AdrianScancich/Mechatronics-Final-Project-Winter26-/docs/images/Bumper.png

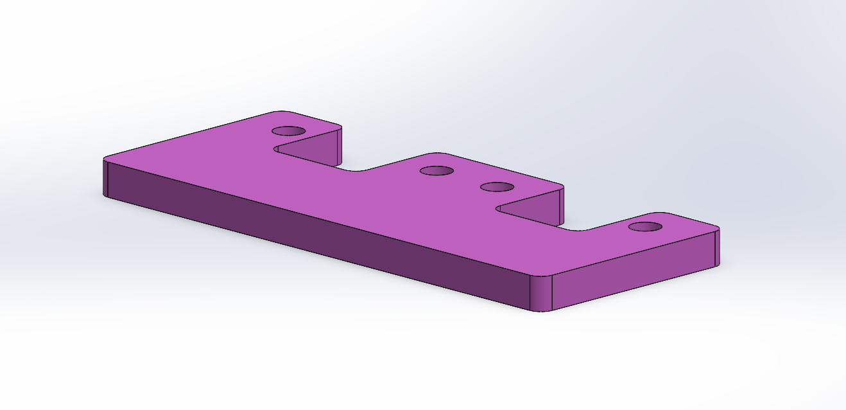
docs/images/Bumper.png
