AdrianScancich/Mechatronics-Final-Project-Winter26-/docs/images/RomiTopDown.jpg

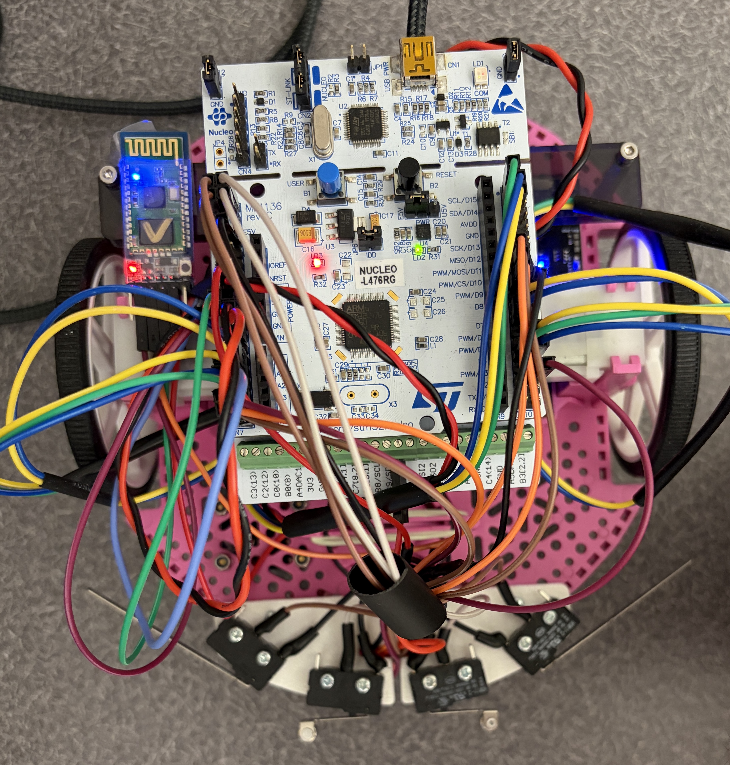
docs/images/RomiTopDown.jpg
