AdrianScancich/Mechatronics-Final-Project-Winter26-/CAD/Bumper.SLDPRT

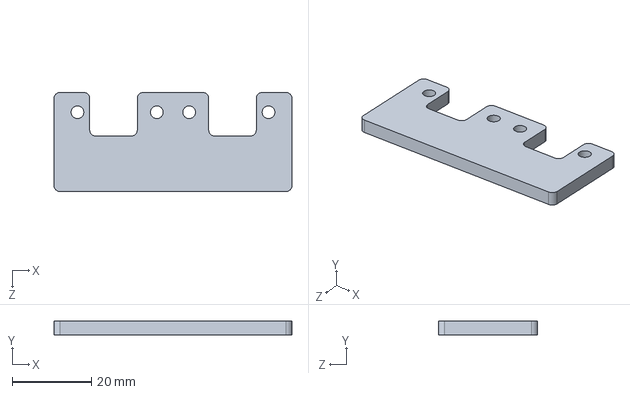
[picture p16: CAD file, 2026-03-20]
CAD/Bumper.SLDPRT
60.0 x 3.50 x 25.0 mm
