AdrianScancich/Mechatronics-Final-Project-Winter26-/CAD/Snap-Action Switch.SLDPRT

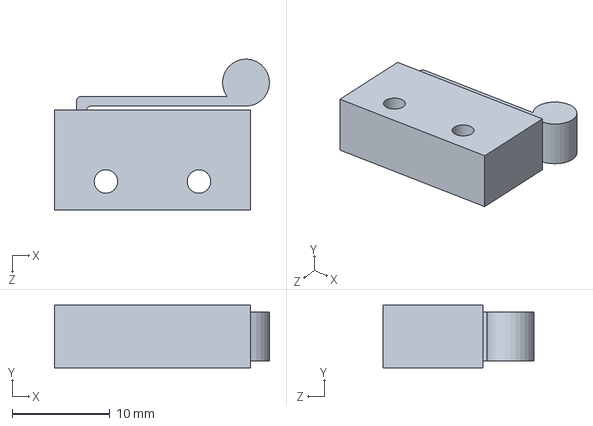
[picture p17: CAD file, 2026-03-20]
CAD/Snap-Action Switch.SLDPRT
21.9 x 6.40 x 15.4 mm
