AdrianScancich/Mechatronics-Final-Project-Winter26-/CAD/IMU Mount.SLDPRT

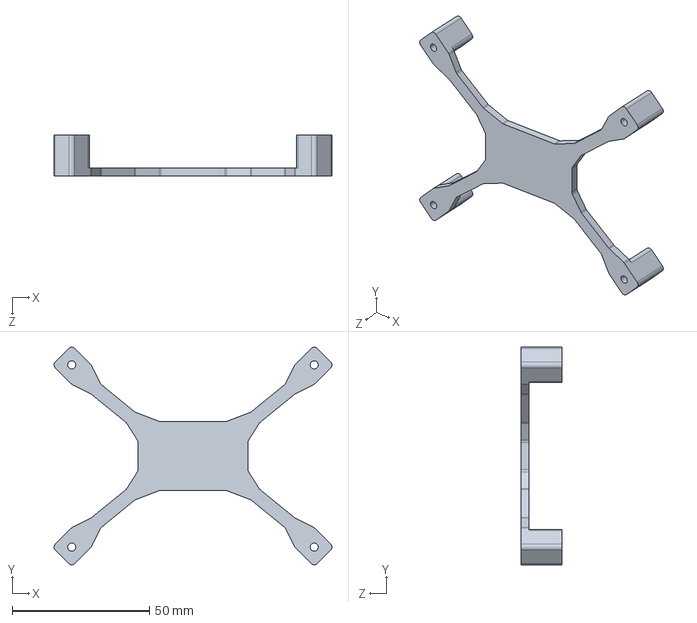
[picture p18: CAD file, 2026-03-20]
CAD/IMU Mount.SLDPRT
101.1 x 79.2 x 15.0 mm
