AdrianScancich/Mechatronics-Final-Project-Winter26-/CAD/qtr-hd-06x.SLDPRT

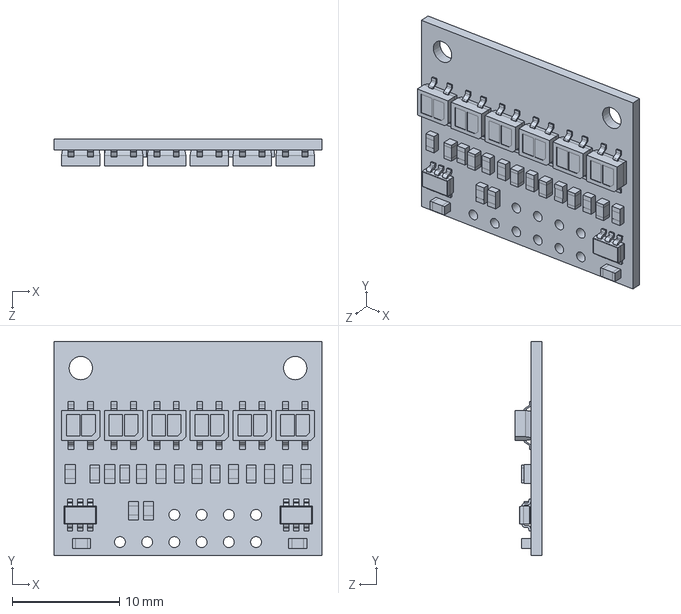
[picture p19: CAD file, 2026-03-20]
CAD/qtr-hd-06x.SLDPRT
25.0 x 20.0 x 2.52 mm
