AdrianScancich/Mechatronics-Final-Project-Winter26-/CAD/QTR Mount.SLDPRT

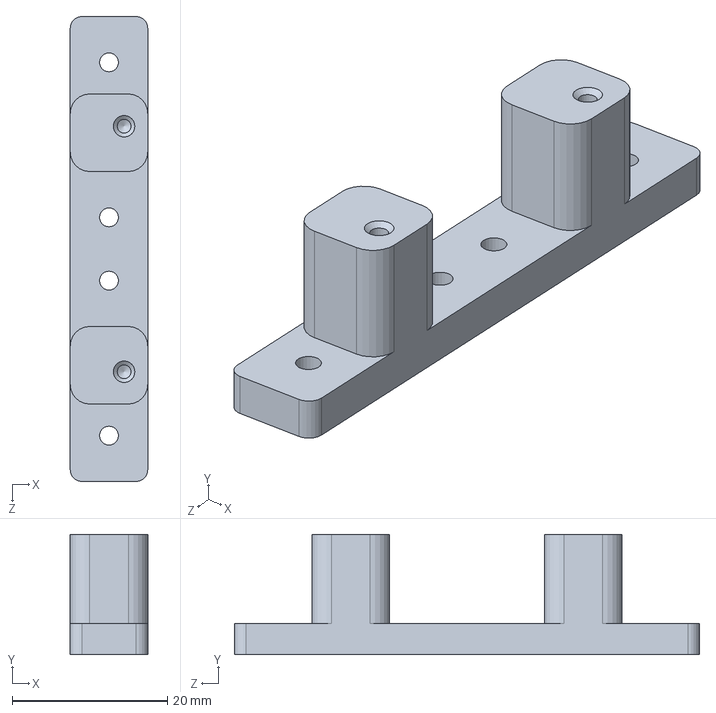
[picture p20: CAD file, 2026-03-20]
CAD/QTR Mount.SLDPRT
10.0 x 15.5 x 60.0 mm
