AdrianScancich/Mechatronics-Final-Project-Winter26-/CAD/Bump Sensor Mount.SLDPRT

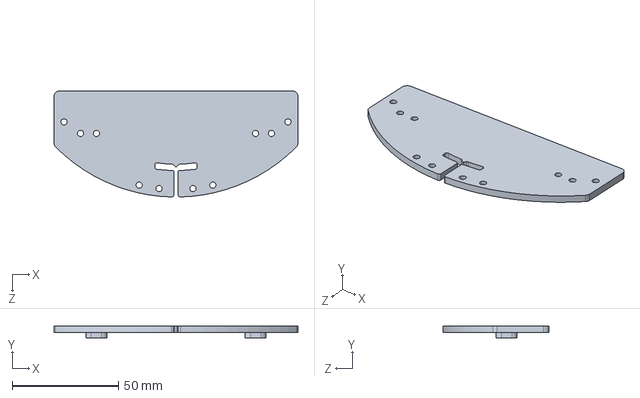
[picture p21: CAD file, 2026-03-20]
CAD/Bump Sensor Mount.SLDPRT
115.0 x 5.50 x 50.0 mm
