AdrianScancich/Mechatronics-Final-Project-Winter26-/(commit log)

2026-03-20 Solidworks CAD files
    [Bump Sensor Mount.SLDPRT, Bumper.SLDPRT, IMU Mount.SLDPRT, QTR Mount.SLDPRT, Snap-Action Switch.SLDPRT, qtr-hd-06x.SLDPRT]
2026-03-20 Delete ME 405 directory
    Replace with CAD directory
    [Bump Sensor Mount.SLDPRT, Bumper.SLDPRT, IMU Mount.SLDPRT, QTR Mount.SLDPRT, Snap-Action Switch.SLDPRT, qtr-hd-06x.SLDPRT]
2026-03-20 SOLIDWORKS CAD
    [Bump Sensor Mount.SLDPRT, Bumper.SLDPRT, IMU Mount.SLDPRT, QTR Mount.SLDPRT, Snap-Action Switch.SLDPRT, qtr-hd-06x.SLDPRT]
2026-03-20 Lab 6 Calibration Code
    Test performance for several experimental runs with varying gain values and setpoints.
